1e1/arduino-obd2-hud/doc/lcd-draft.png

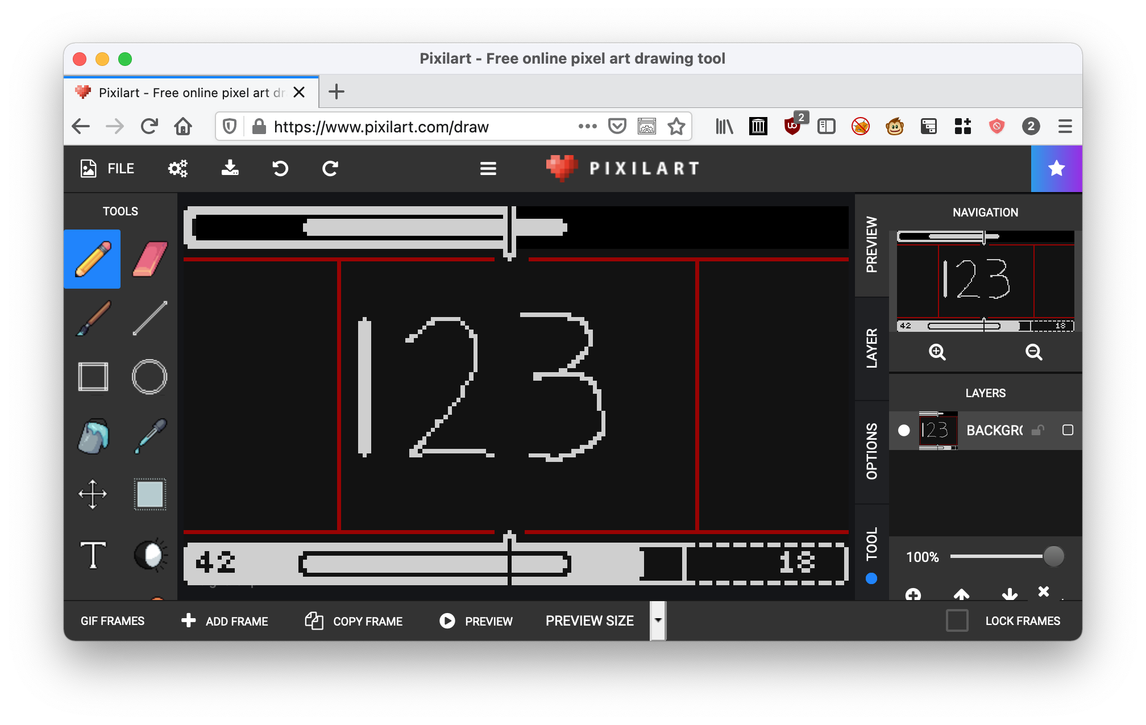
doc/lcd-draft.png
