1e1/arduino-obd2-hud/doc/lcd-driving.jpg

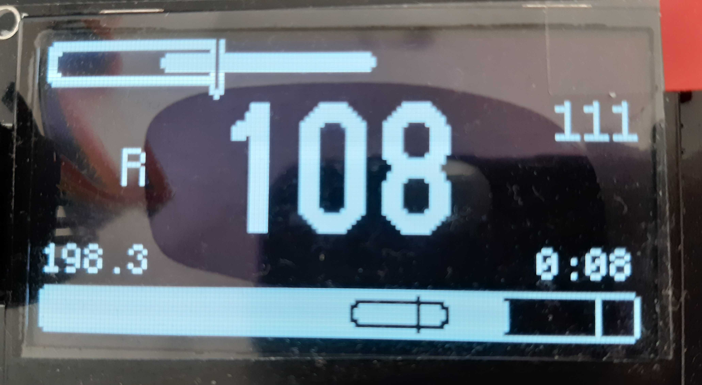
doc/lcd-driving.jpg
