1e1/arduino-obd2-hud/doc/lcd-idle.jpg

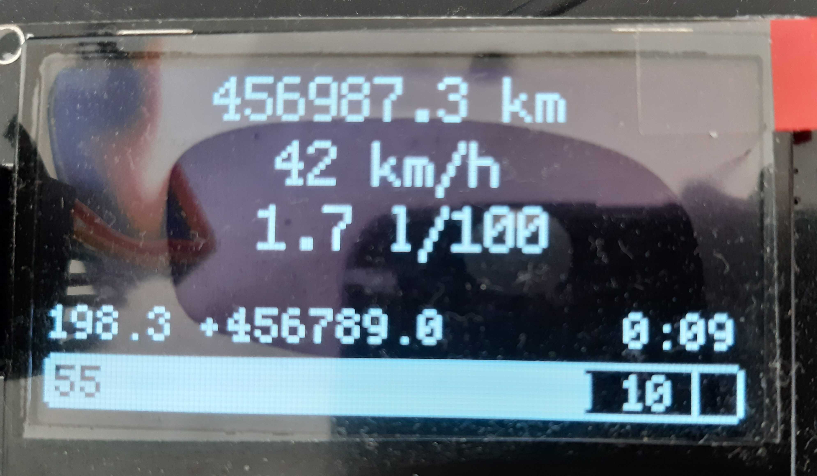
doc/lcd-idle.jpg
