1e1/arduino-obd2-hud/doc/scan-chrome.png

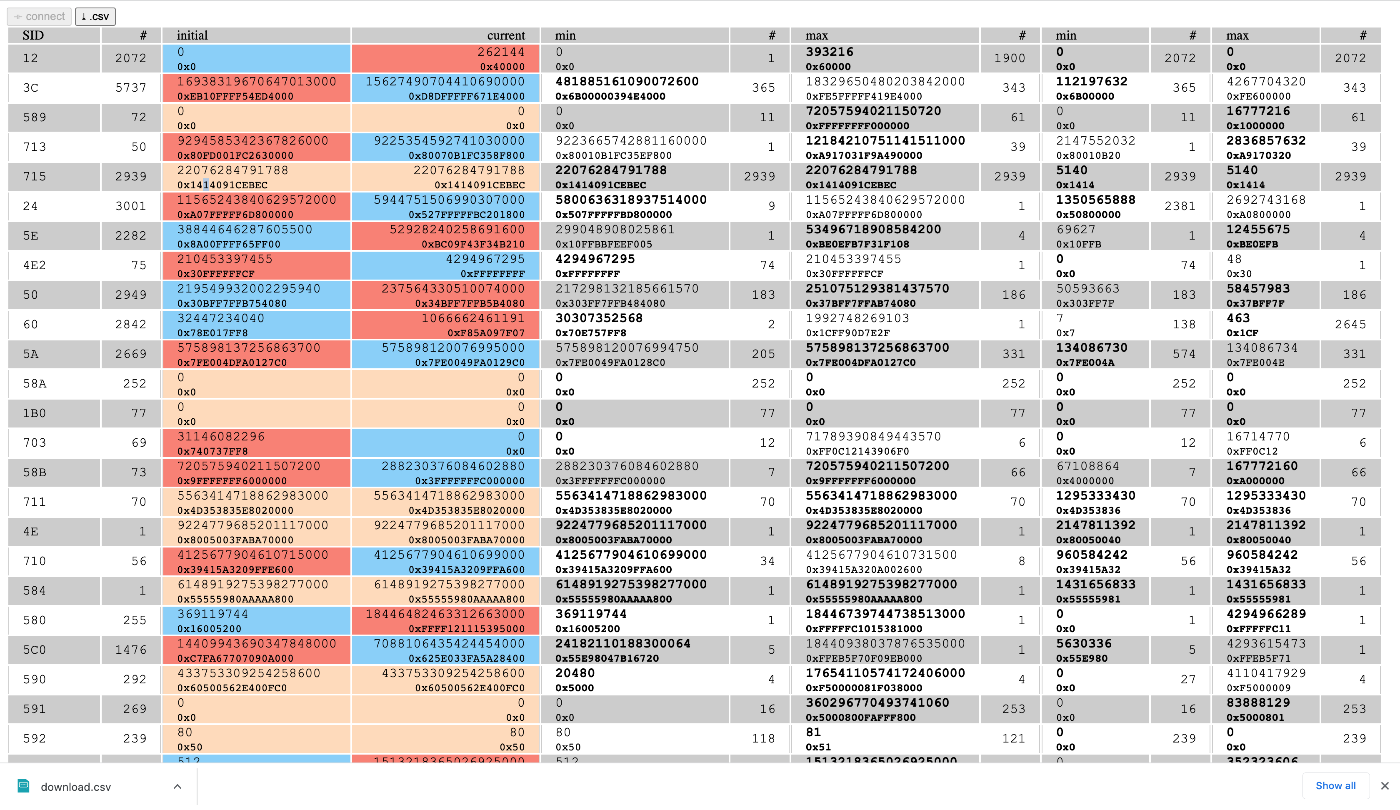
doc/scan-chrome.png
