1e1/arduino-obd2-hud/doc/workflow-draft.png

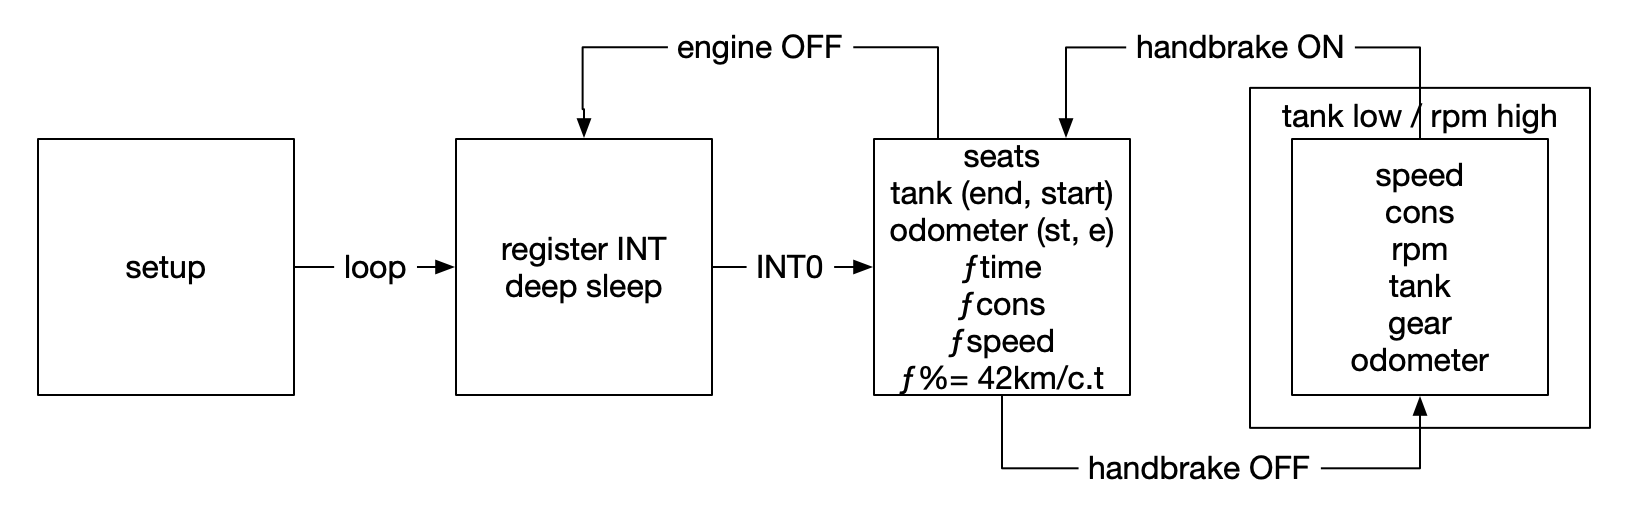
doc/workflow-draft.png
