1e1/arduino-obd2-hud/vw-hud/_constants.h

#ifndef constants_H_
#define constants_H_


#define TANK_CAPACITY_MAX           70
#define SCREEN_BRIGHTNESS_DAY       200
#define SCREEN_BRIGHTNESS_NIGHT     100

// OBD-II PIDs removed: the firmware now reads native PQ CAN.
// Native message IDs / signal bit-offsets live in _can.h.


#endif
