1e1/arduino-obd2-hud/(commit log)

2023-05-26 new tool for analysing the canbus
2023-10-24 fix debugging tool - display frame content + export CSV
